AndriyKurdyukov/DigitalThermometer/Hardware/BOM.txt

Reference	Qty	Value	DNP	Exclude from BOM	Exclude from Board	Footprint	Datasheet
C1,C2	2	22uF				Capacitor_SMD:C_0805_2012Metric	~
C3	1	100nF				Capacitor_SMD:C_0402_1005Metric	~
C4	1	4.7uF				Capacitor_SMD:C_0603_1608Metric	~
C5	1	100 nF				Capacitor_SMD:C_0402_1005Metric	~
C6	1	1uF				Capacitor_SMD:C_0603_1608Metric	~
C7	1	0.47uF				Capacitor_SMD:C_0402_1005Metric	~
C8	1	1uF				Capacitor_SMD:C_0402_1005Metric	~
C9	1	10nF				Capacitor_SMD:C_0402_1005Metric	~
D1	1	LED_YELLOW				LED_SMD:LED_0603_1608Metric	~
D2	1	LED_GREEN				LED_SMD:LED_0603_1608Metric	~
J1	1	UART				Connector_PinSocket_2.54mm:PinSocket_1x02_P2.54mm_Vertical	~
J2	1	Barrel_Jack_Switch				WURTH_DC_BUCHSE:Wurth_Barreljack_694106301002	~
J3	1	SWD				Connector_PinSocket_2.54mm:PinSocket_1x05_P2.54mm_Vertical	~
L1	1	1000 Ohm				Inductor_SMD:L_0603_1608Metric	~
R1	1	10K				Resistor_SMD:R_0402_1005Metric	~
R2,R3	2	1k5				Resistor_SMD:R_0402_1005Metric	~
R4,R5	2	10kOhm				Resistor_SMD:R_0402_1005Metric	~
U1	1	STM32F030F4P6				Package_SO:TSSOP-20_4.4x6.5mm_P0.65mm	https://www.st.com/resource/en/datasheet/stm32f030f4.pdf
U2	1	TMP117AIDRVR				Package_SON:WSON-6-1EP_2x2mm_P0.65mm_EP1x1.6mm	https://www.ti.com/lit/ds/symlink/tmp117.pdf
U3	1	NHD-C0220BIZ				Display:NHD-C0220BiZ	http://www.newhavendisplay.com/specs/NHD-C0220BiZ-FSW-FBW-3V3M.pdf
U4	1	AMS1117-3.3				Package_TO_SOT_SMD:SOT-223-3_TabPin2	http://www.advanced-monolithic.com/pdf/ds1117.pdf
