AndriyKurdyukov/DigitalThermometer/Hardware/WeatherStation.kicad_pcb

## KiCad design Hardware/WeatherStation.kicad_pcb (2026-10-11)

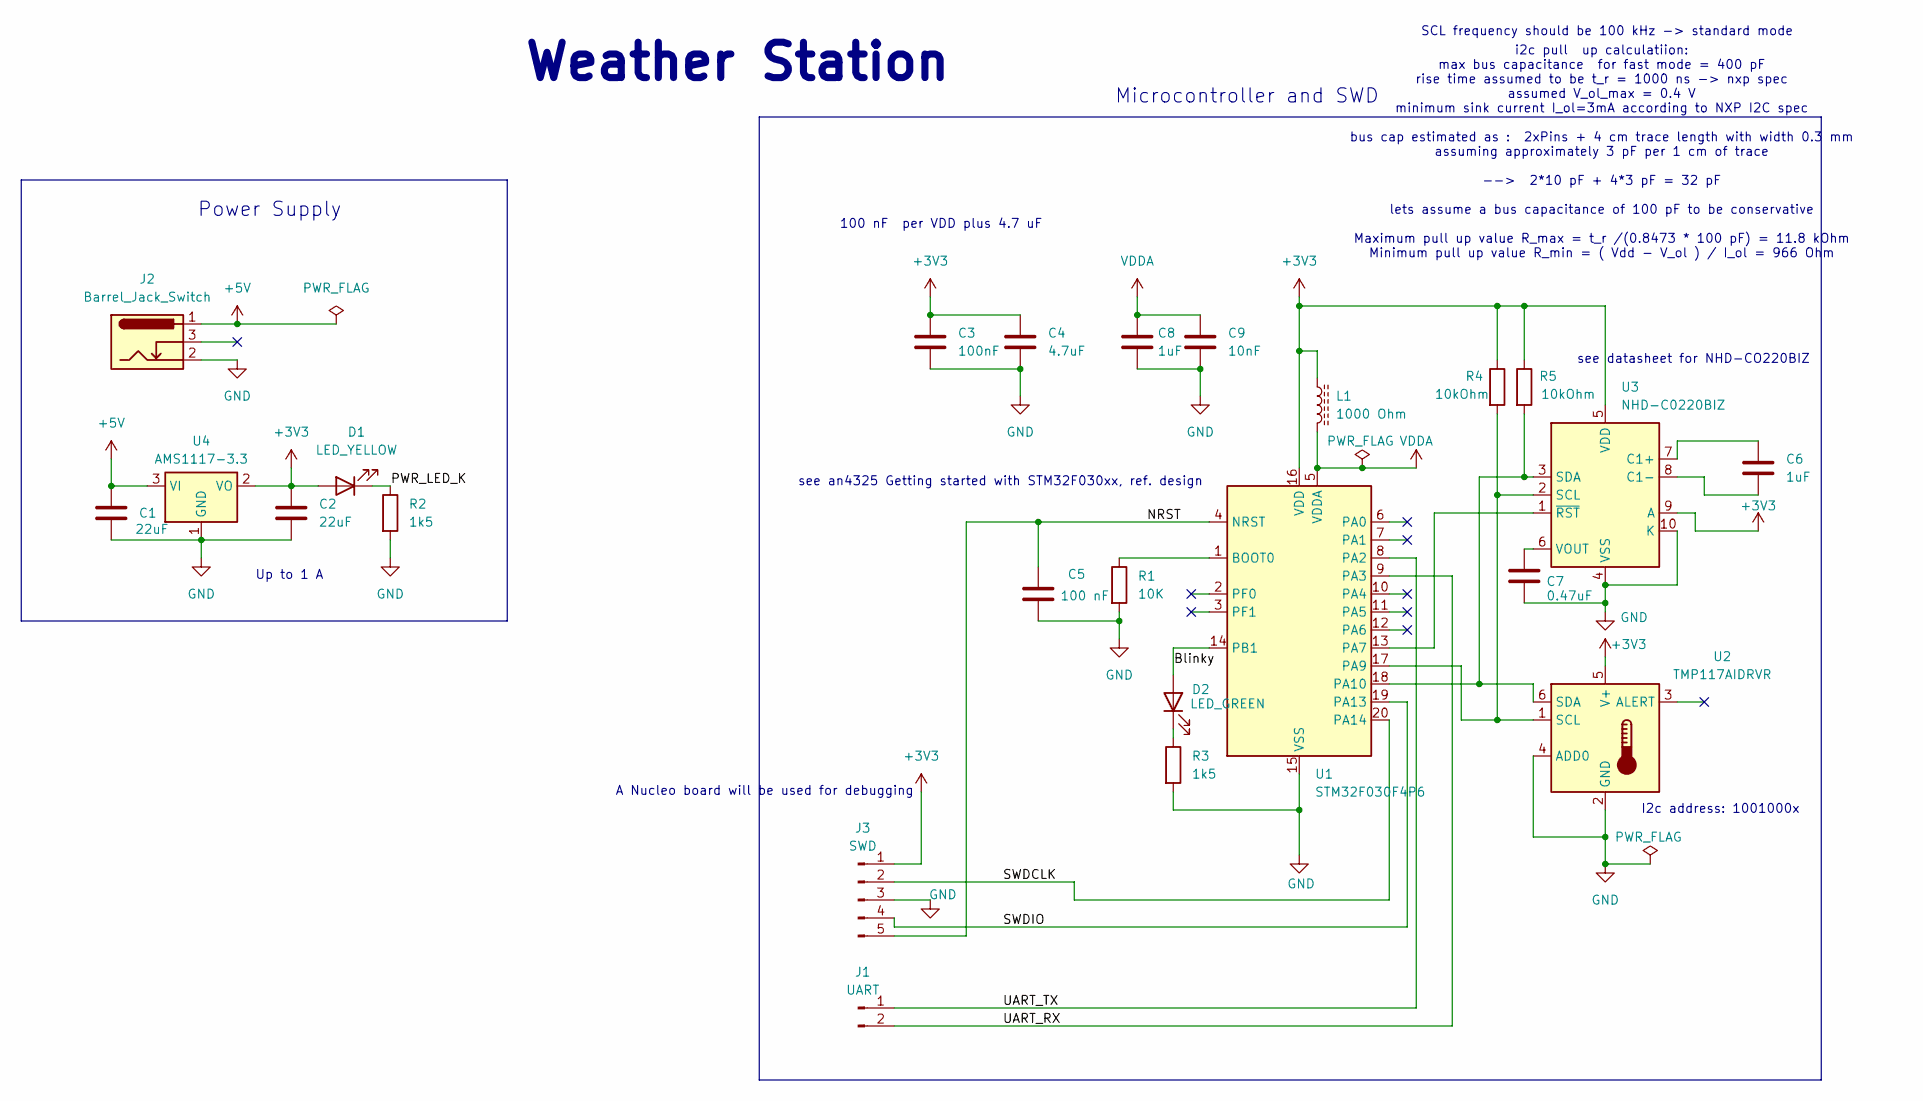
[picture p2: schematic WeatherStation.kicad_sch, Weather Station]

Parts:
C1, C2: 22uF; C_0805_2012Metric
C3: 100nF; C_0402_1005Metric
C4: 4.7uF; C_0603_1608Metric
C5: 100 nF; C_0402_1005Metric
C6: 1uF; C_0603_1608Metric
C7: 0.47uF; C_0402_1005Metric
C8: 1uF; C_0402_1005Metric
C9: 10nF; C_0402_1005Metric
D1: LED_YELLOW; LED_0603_1608Metric
D2: LED_GREEN; LED_0603_1608Metric
J1: UART; PinSocket_1x02_P2.54mm_Vertical
J2: Barrel_Jack_Switch; Wurth_Barreljack_694106301002
J3: SWD; PinSocket_1x05_P2.54mm_Vertical
L1: 1000 Ohm; L_0603_1608Metric
R1: 10K; R_0402_1005Metric
R2, R3: 1k5; R_0402_1005Metric
R4, R5: 10kOhm; R_0402_1005Metric
U1: STM32F030F4P6; TSSOP-20_4.4x6.5mm_P0.65mm
U2: TMP117AIDRVR; WSON-6-1EP_2x2mm_P0.65mm_EP1x1.6mm
U3: NHD-C0220BIZ; NHD-C0220BiZ
U4: AMS1117-3.3; SOT-223-3_TabPin2

Connections:
+3V3: C2.1, C3.1, C4.1, D1.2 (A), J3.1, L1.1, R4.1, R5.1, U1.16 (VDD), U2.5 (V+), U3.5 (VDD), U3.9 (A), U4.2 (VO)
+5V: C1.1, J2.1, U4.3 (VI)
/Blinky: D2.2 (A), U1.14 (PB1)
/NRST: C5.1, J3.5, U1.4 (NRST)
/PWR_LED_K: D1.1 (K), R2.1
/SWDCLK: J3.2, U1.20 (PA14)
/SWDIO: J3.4, U1.19 (PA13)
/UART_RX: J1.2, U1.9 (PA3)
/UART_TX: J1.1, U1.8 (PA2)
GND: C1.2, C2.2, C3.2, C4.2, C5.2, C7.2, C8.2, C9.2, J2.2, J3.3, R1.2, R2.2, R3.2, U1.15 (VSS), U2.2 (GND), U2.4 (ADD0), U3.4 (VSS), U3.10 (K), U4.1 (GND)
unnamed: D2.1 (K), R3.1
unnamed: R1.1, U1.1 (BOOT0)
unnamed: U1.13 (PA7), U3.1 (~RST)
unnamed: R4.2, U1.17 (PA9), U2.1 (SCL), U3.2 (SCL)
unnamed: R5.2, U1.18 (PA10), U2.6 (SDA), U3.3 (SDA)
unnamed: C6.2, U3.7 (C1+)
unnamed: C6.1, U3.8 (C1-)
unnamed: C7.1, U3.6 (VOUT)
VDDA: C8.1, C9.1, L1.2, U1.5 (VDDA)

Notes on the sheet:
A Nucleo board will be used for debugging
SCL frequency should be 100 kHz -> standard mode
Up to 1 A
Microcontroller and SWD
I2c address: 1001000x
Power Supply
i2c pull up calculatiion: max bus capacitance for fast mode = 400 pF rise time assumed to be t_r = 1000 ns -> nxp spec assumed V_ol_max = 0.4 V minimum sink current I_ol=3mA according to NXP I2C spec bus cap estimated as : 2xPins + 4 cm trace length with width 0.3 mm assuming approximately 3 pF per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
see datasheet for NHD-CO220BIZ
see an4325 Getting started with STM32F030xx, ref. design
Weather Station
100 nF per VDD plus 4.7 uF

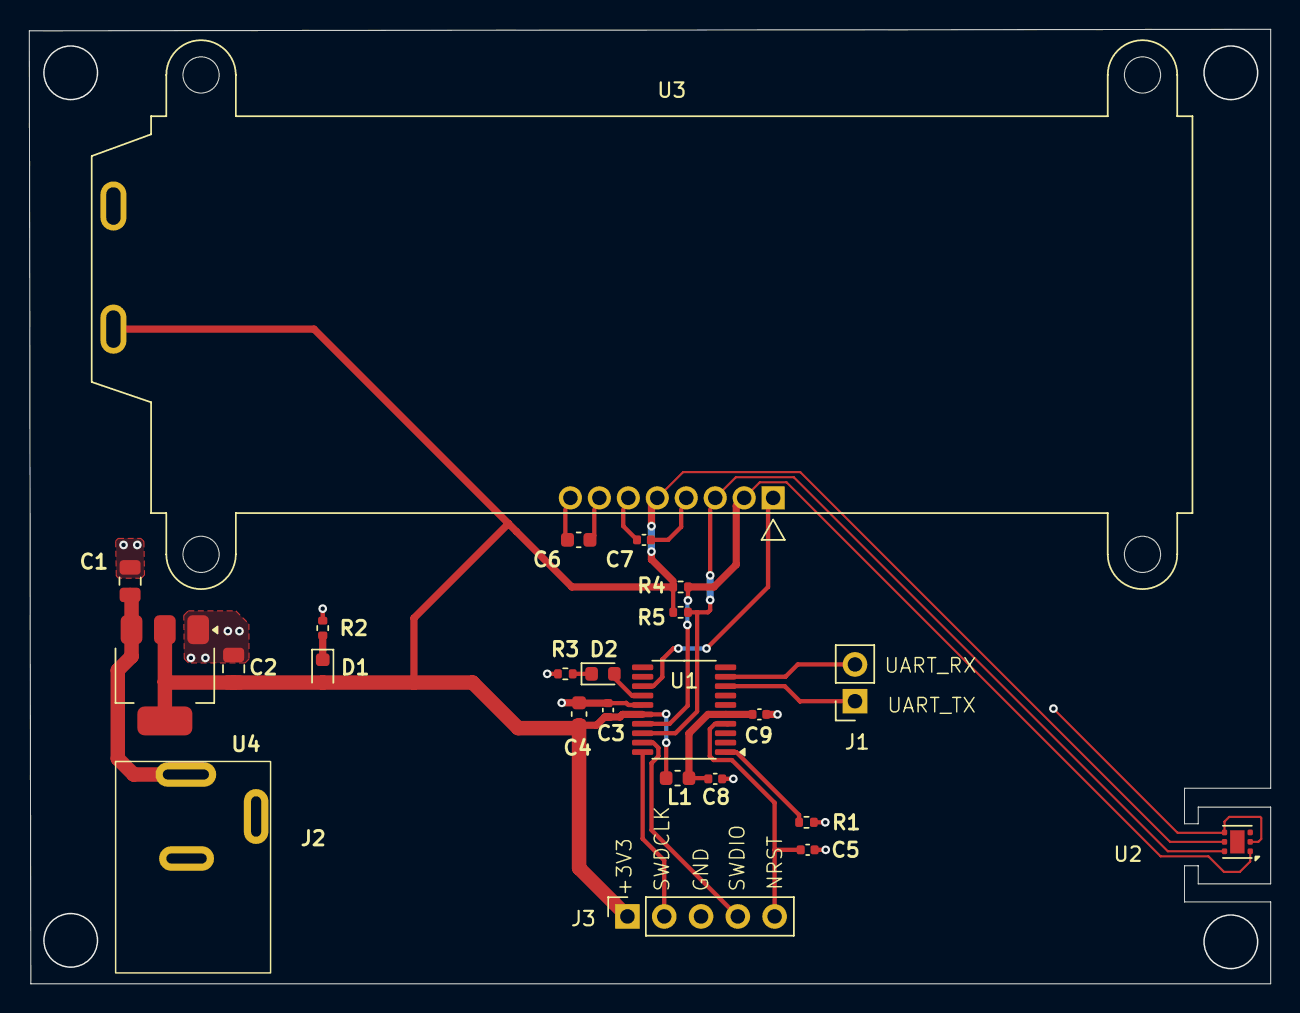
[picture p3: board WeatherStation.kicad_pcb from above]

Board: 2 copper layers, 85.7 x 65.9 mm, 24 parts (0 on the bottom side), 19 nets.
