AndriyKurdyukov/DigitalThermometer/(commit log)

2026-10-11 hardware folder added
    [WeatherStation.kicad_pcb, WeatherStation.kicad_sch]
2026-10-20 -rewriting I2C library using LL
2026-10-21 - i2c library implemented using Lower Layer
2026-10-31 -device photo added
