AndriyKurdyukov/DigitalThermometer/pictures/digital_thermometer.jpg

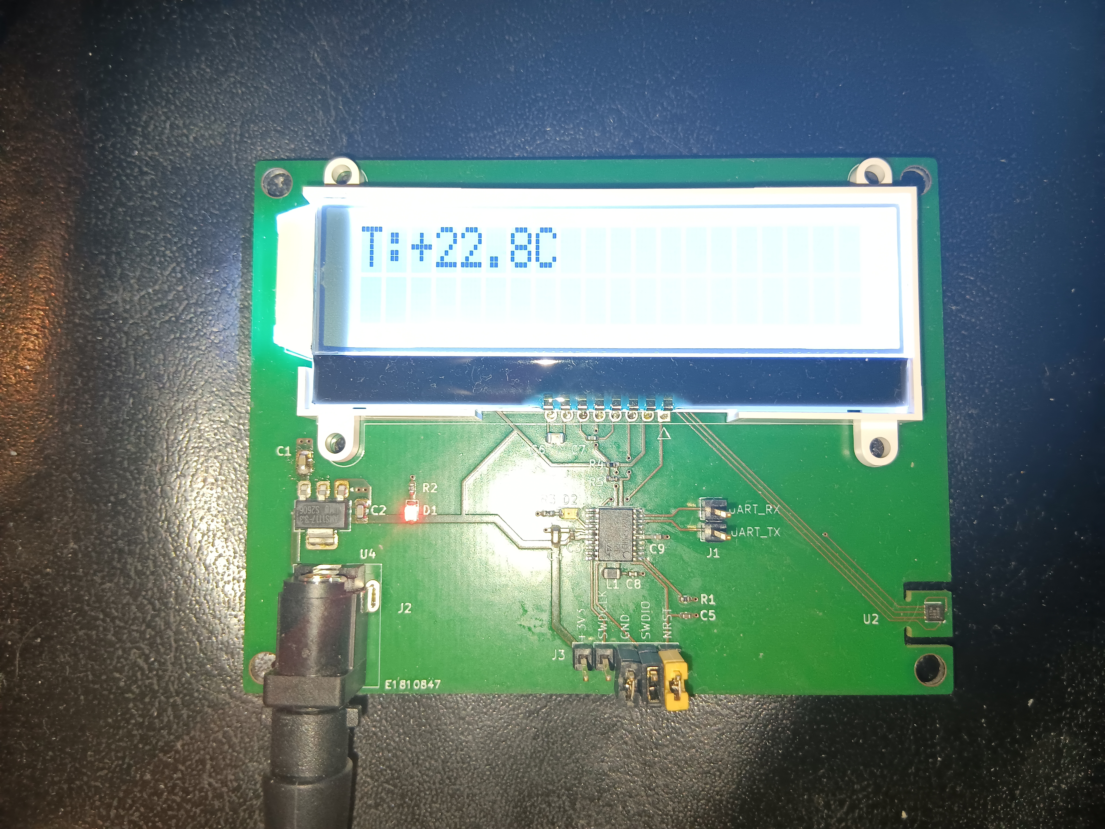
[picture p1: pictures/digital_thermometer.jpg]
pictures/digital_thermometer.jpg
